HashDefineElectronics/Central-Command/Documentation/Programming Cable Assembly Images/IMG_1886.JPG

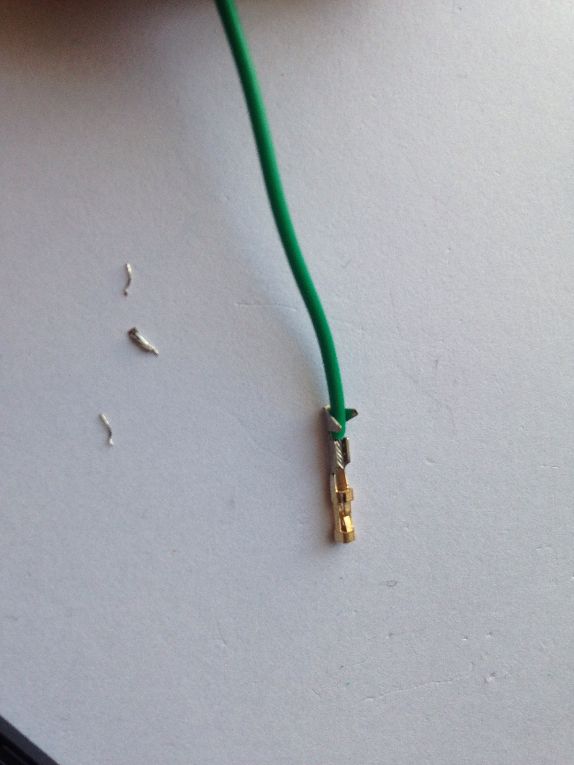
Documentation/Programming Cable Assembly Images/IMG_1886.JPG
