HashDefineElectronics/Central-Command/Documentation/Programming Cable Assembly Images/IMG_1889.JPG

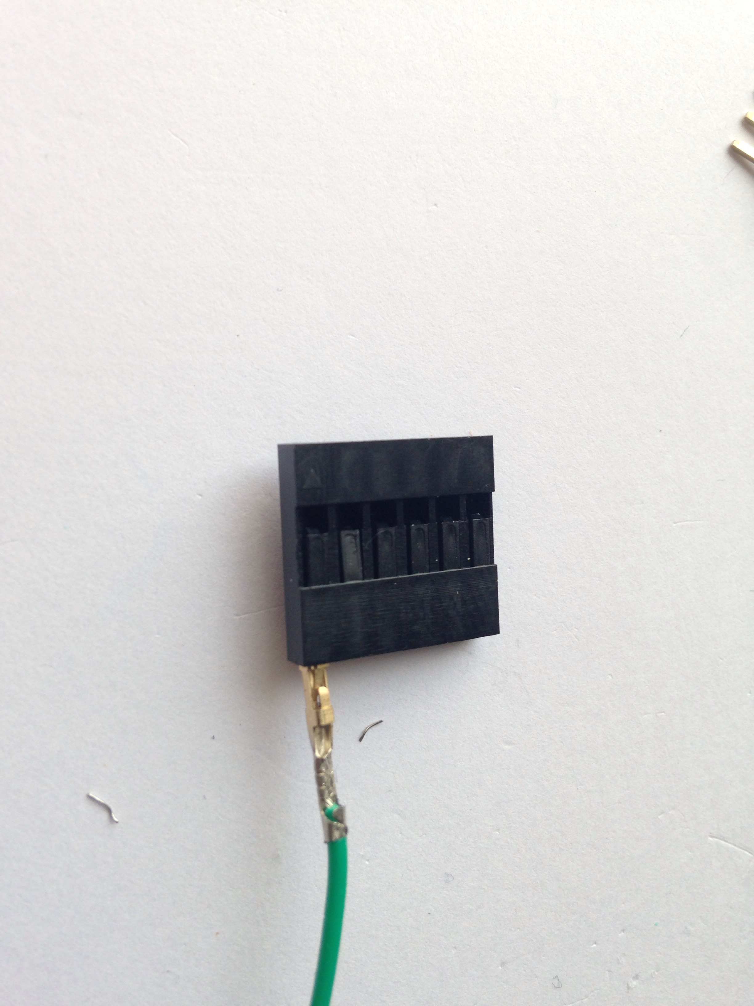
Documentation/Programming Cable Assembly Images/IMG_1889.JPG
