HashDefineElectronics/Central-Command/README.md

# Central-Command
The centralized board that will control the roll with it project
