HashDefineElectronics/Central-Command/Documentation/Specifications.md

# Specifications

## Hardware

*  Hardware review
*  Compiled parts BOM

## Firmware

*  Create CC firmware as makefile
*  Setup unity
*  Create Eclipse CC project

## Repository

*  Setup the .gitignore
*  Create project readme.md

## TDD

## Modular Firmware
