HashDefineElectronics/Central-Command/Hardware/Central Command Invert Small.png

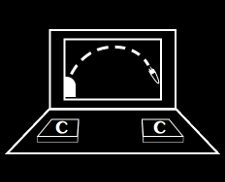
Hardware/Central Command Invert Small.png
