HashDefineElectronics/Central-Command/Documentation/Programming Cable Assembly Images/IMG_1882.JPG

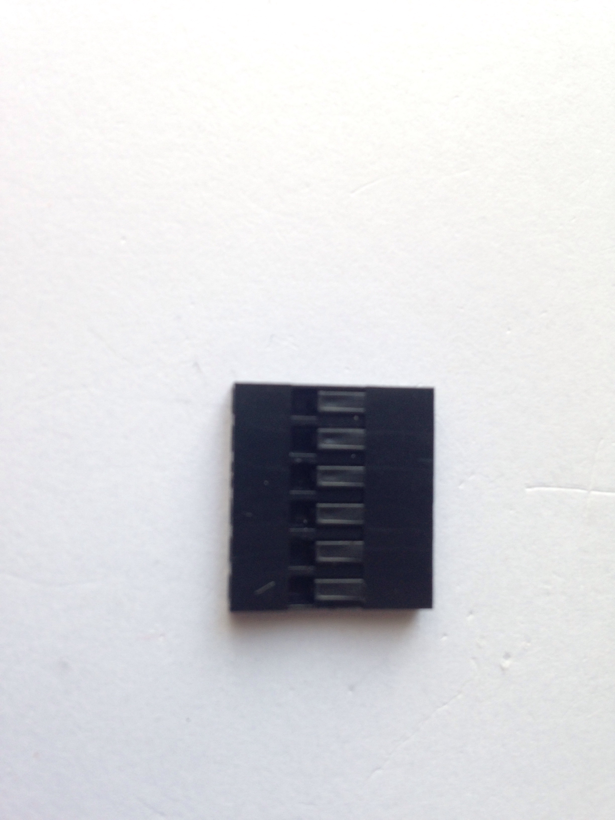
Documentation/Programming Cable Assembly Images/IMG_1882.JPG
