HashDefineElectronics/Central-Command/Documentation/Programming Cable Assembly Images/IMG_1883.JPG

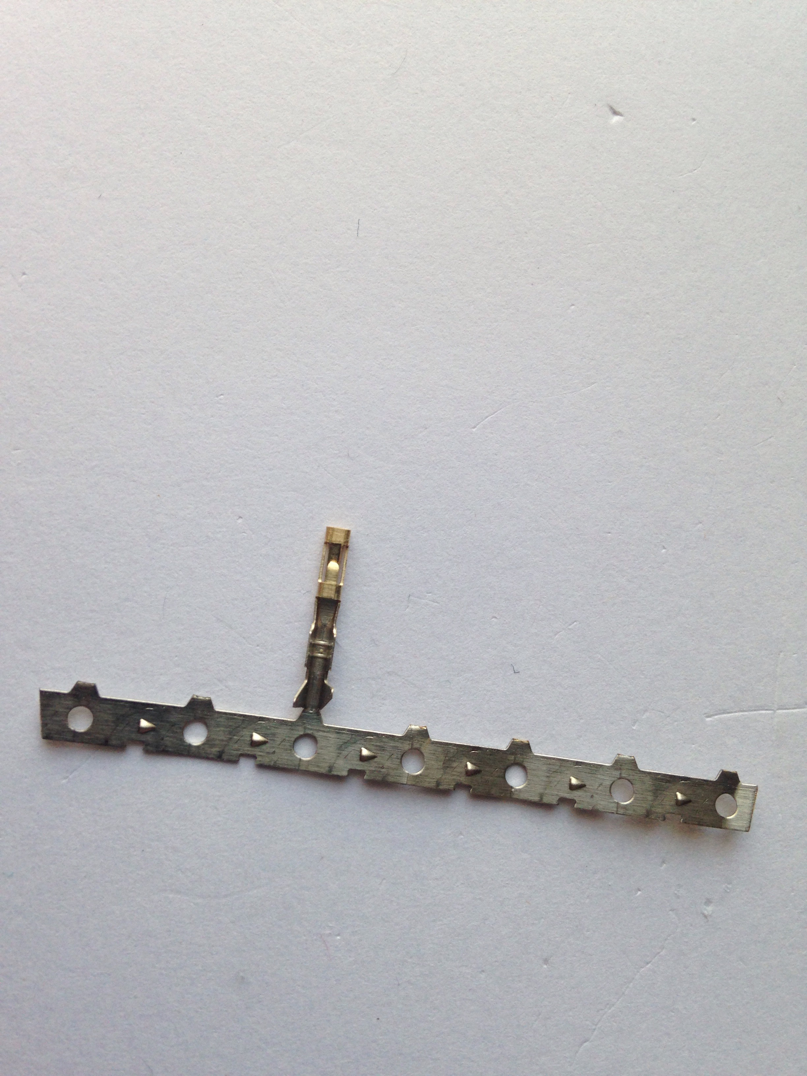
Documentation/Programming Cable Assembly Images/IMG_1883.JPG
