HashDefineElectronics/Central-Command/Documentation/Programming Cable Assembly Images/IMG_1884.JPG

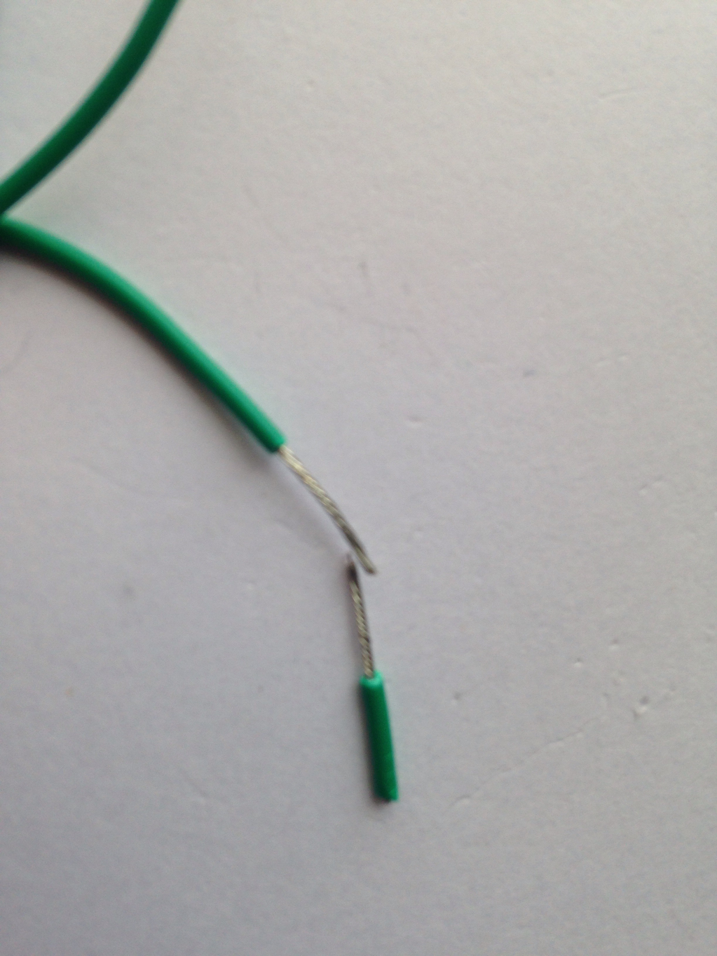
Documentation/Programming Cable Assembly Images/IMG_1884.JPG
