HashDefineElectronics/Central-Command/Documentation/Programming Cable Assembly Images/IMG_1885.JPG

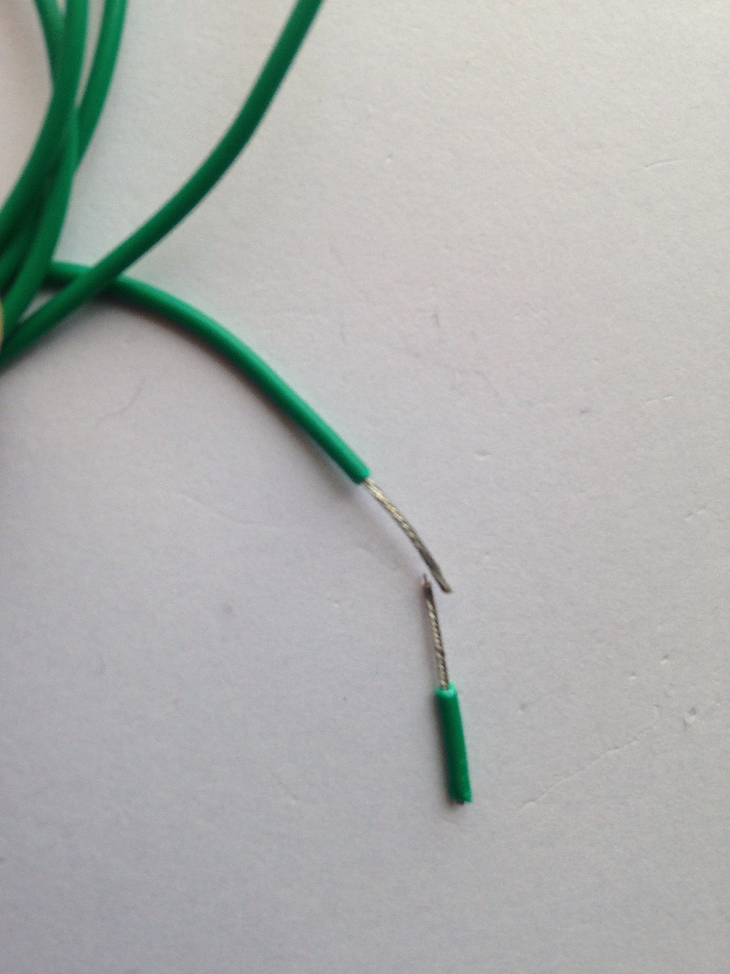
Documentation/Programming Cable Assembly Images/IMG_1885.JPG
