HashDefineElectronics/Central-Command/Documentation/Programming Cable Assembly Images/IMG_1887.JPG

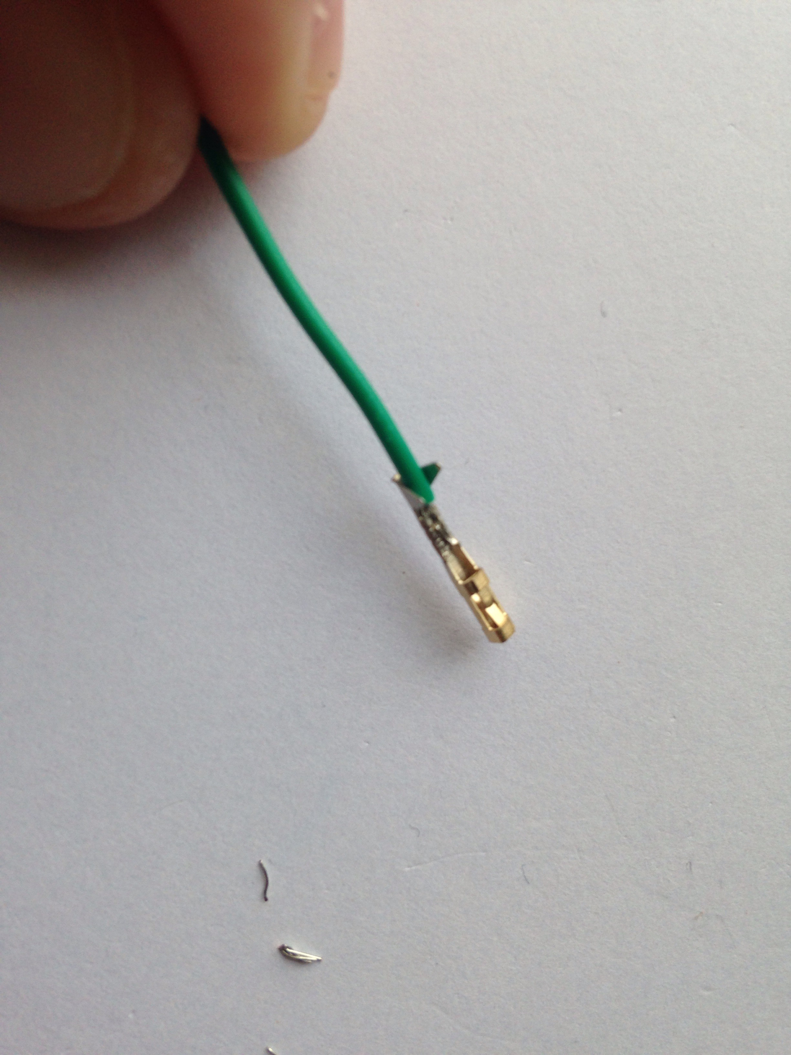
Documentation/Programming Cable Assembly Images/IMG_1887.JPG
