HashDefineElectronics/Central-Command/Documentation/Programming Cable Assembly Images/IMG_1888.JPG

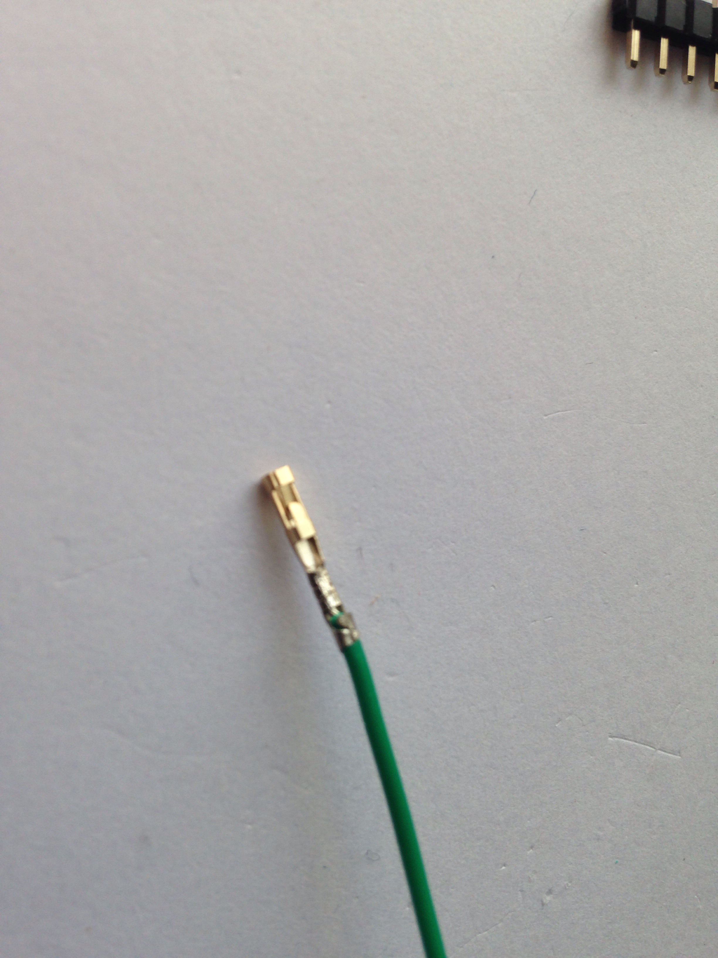
Documentation/Programming Cable Assembly Images/IMG_1888.JPG
