HashDefineElectronics/Central-Command/Documentation/Programming Cable Assembly Images/IMG_1890.JPG

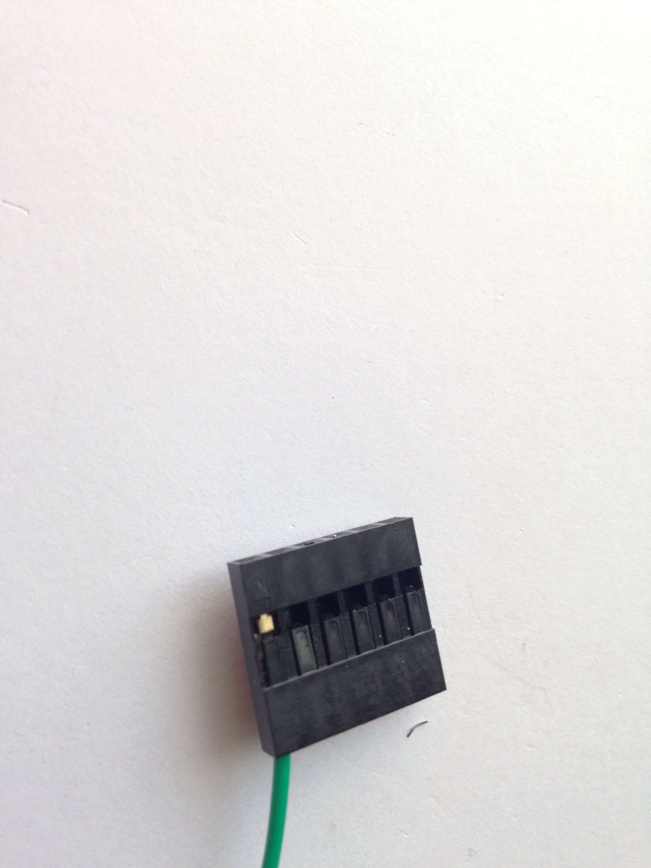
Documentation/Programming Cable Assembly Images/IMG_1890.JPG
