HashDefineElectronics/Central-Command/Hardware/CentralCommand.kicad_pcb

## KiCad design Hardware/CentralCommand.kicad_pcb (2016-02-22)

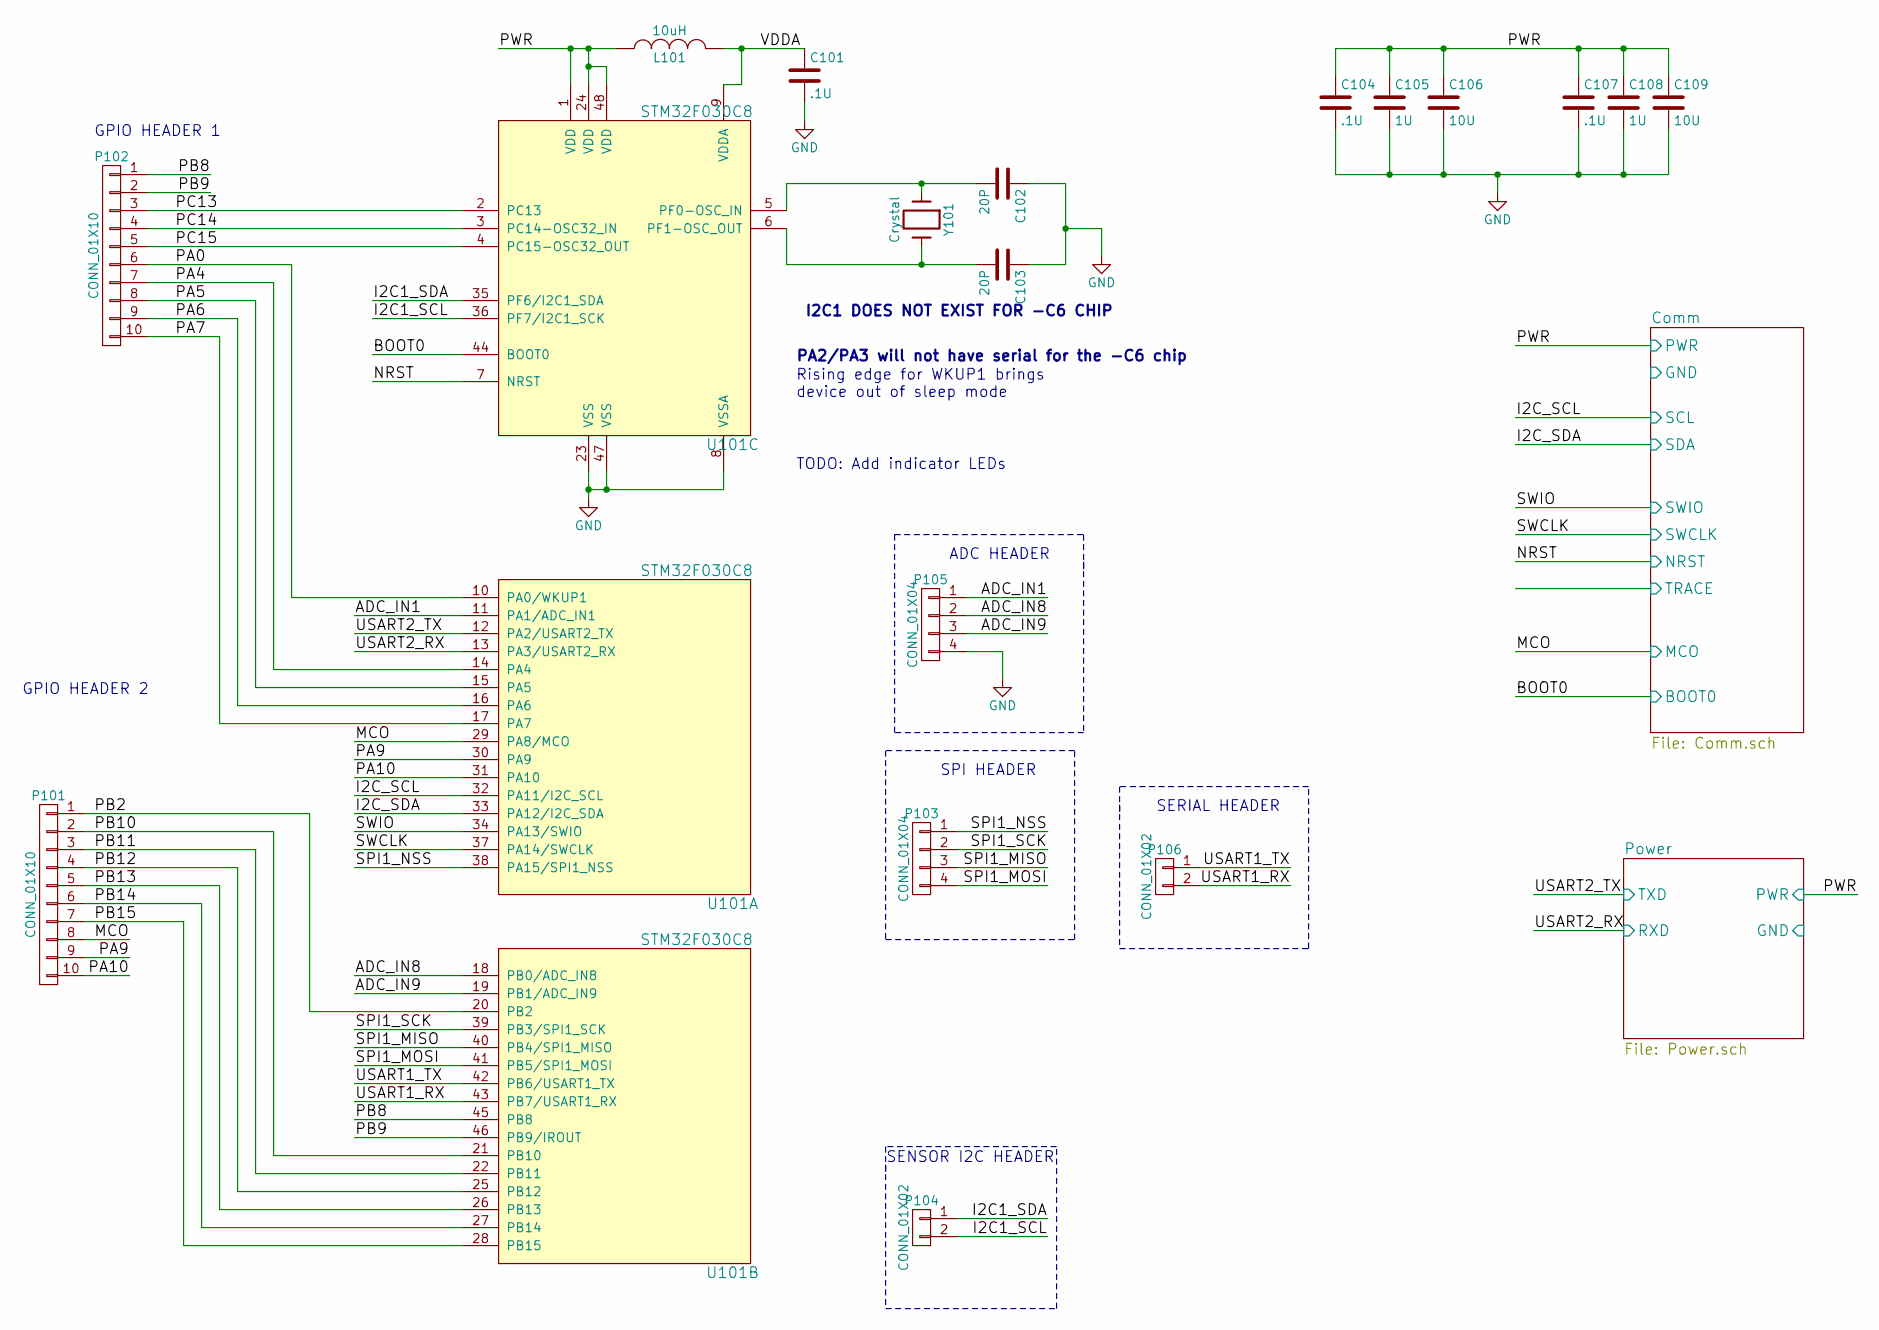
[picture p11: schematic CentralCommand.sch, Central Command]

Parts:
C101, C104, C107: .1U; C_0805; MPN 0805B104K500CT; Farnell 2496944
C102, C103: 20P; C_0805; MPN 08055A200JAT2A; Farnell 2332762
C105, C108: 1U; C_1206; MPN MCSH31B105K100CT; Farnell 1856632
C106, C109: 10U; C_1206; MPN MC1206B106K160CT; Farnell 2320921
L101: 10uH; Neosid_Inductor_SM1206; MPN LQH31CN100K03L; Farnell 1515399
P101, P102: CONN_01X10; Pin_Header_Straight_1x10; MPN M20-9991046; Farnell 1022261
P103, P105: CONN_01X04; Pin_Header_Straight_1x04; MPN M20-9990446; Farnell 1022251
P104, P106: CONN_01X02; Pin_Header_Straight_1x02; MPN M20-9990246; Farnell 1022247
U101: STM32F030C8; LQFP-48_7x7mm_Pitch0.5mm; MPN STM32F030C8; Farnell 2393634
Y101: Crystal; Crystal_HC49-U_Vertical; MPN FOXSLF/080-20; Farnell 2063945

Connections:
/ADC_IN1: P105.1, U101.11 (PA1/ADC_IN1)
/ADC_IN8: P105.2, U101.18 (PB0/ADC_IN8)
/ADC_IN9: P105.3, U101.19 (PB1/ADC_IN9)
/Comm/BOOT0: U101.44 (BOOT0); also elsewhere on the board
/Comm/NRST: U101.7 (NRST); also elsewhere on the board
/Comm/PWR: C104.1, C105.1, C106.1, C107.1, C108.1, C109.1, L101.1, U101.1 (VDD), U101.24 (VDD), U101.48 (VDD); also elsewhere on the board
/Comm/SCL: U101.32 (PA11/I2C_SCL); also elsewhere on the board
/Comm/SDA: U101.33 (PA12/I2C_SDA); also elsewhere on the board
/Comm/SWCLK: U101.37 (PA14/SWCLK); also elsewhere on the board
/Comm/SWIO: U101.34 (PA13/SWIO); also elsewhere on the board
/I2C1_SCL: P104.2, U101.36 (PF7/I2C1_SCK)
/I2C1_SDA: P104.1, U101.35 (PF6/I2C1_SDA)
/MCO: P101.8, U101.29 (PA8/MCO)
/PA0: P102.6, U101.10 (PA0/WKUP1)
/PA4: P102.7, U101.14 (PA4)
/PA5: P102.8, U101.15 (PA5)
/PA6: P102.9, U101.16 (PA6)
/PA7: P102.10, U101.17 (PA7)
/PA9: P101.9, U101.30 (PA9)
/PA10: P101.10, U101.31 (PA10)
/PB2: P101.1, U101.20 (PB2)
/PB8: P102.1, U101.45 (PB8)
/PB9: P102.2, U101.46 (PB9/IROUT)
/PB10: P101.2, U101.21 (PB10)
/PB11: P101.3, U101.22 (PB11)
/PB12: P101.4, U101.25 (PB12)
/PB13: P101.5, U101.26 (PB13)
/PB14: P101.6, U101.27 (PB14)
/PB15: P101.7, U101.28 (PB15)
/PC13: P102.3, U101.2 (PC13)
/PC14: P102.4, U101.3 (PC14-OSC32_IN)
/PC15: P102.5, U101.4 (PC15-OSC32_OUT)
/Power/RXD: U101.13 (PA3/USART2_RX); also elsewhere on the board
/Power/TXD: U101.12 (PA2/USART2_TX); also elsewhere on the board
/SPI1_MISO: P103.3, U101.40 (PB4/SPI1_MISO)
/SPI1_MOSI: P103.4, U101.41 (PB5/SPI1_MOSI)
/SPI1_NSS: P103.1, U101.38 (PA15/SPI1_NSS)
/SPI1_SCK: P103.2, U101.39 (PB3/SPI1_SCK)
/USART1_RX: P106.2, U101.43 (PB7/USART1_RX)
/USART1_TX: P106.1, U101.42 (PB6/USART1_TX)
/VDDA: C101.1, L101.2, U101.9 (VDDA)
GND: C101.2, C102.1, C103.1, C104.2, C105.2, C106.2, C107.2, C108.2, C109.2, P105.4, U101.8 (VSSA), U101.23 (VSS), U101.47 (VSS); also elsewhere on the board
unnamed: C102.2, U101.5 (PF0-OSC_IN), Y101.1
unnamed: C103.2, U101.6 (PF1-OSC_OUT), Y101.2

Notes on the sheet:
I2C1 DOES NOT EXIST FOR -C6 CHIP
PA2/PA3 will not have serial for the -C6 chip
Rising edge for WKUP1 brings device out of sleep mode
GPIO HEADER 1
ADC HEADER
SPI HEADER
SERIAL HEADER
SENSOR I2C HEADER
GPIO HEADER 2
TODO: Add indicator LEDs

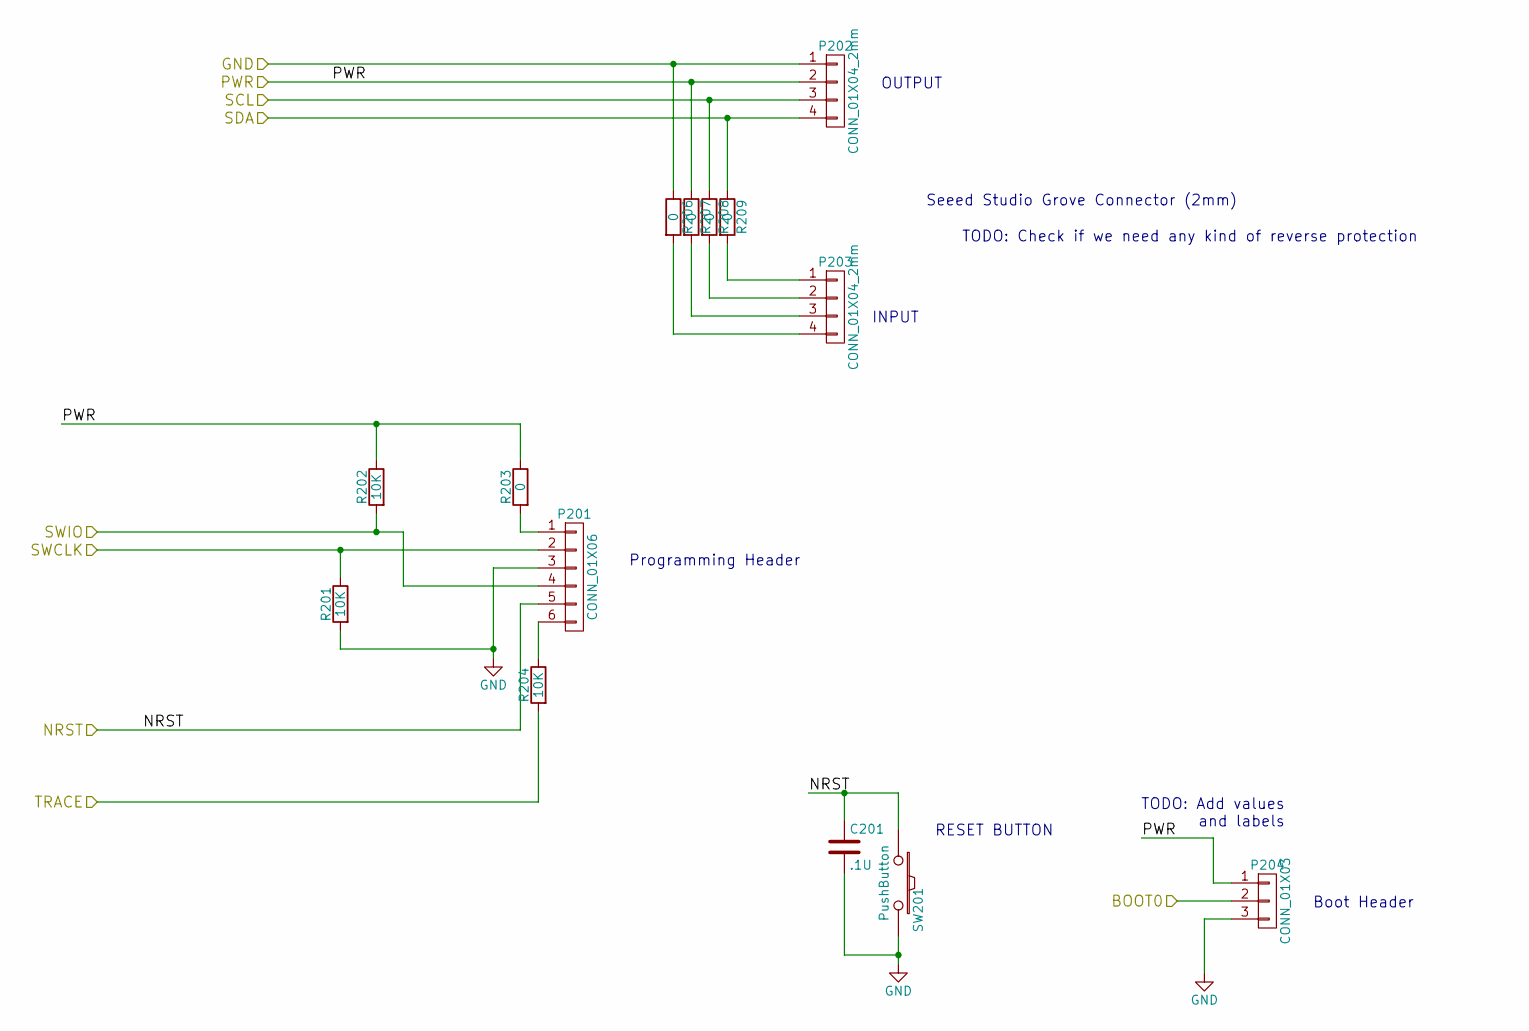
[picture p12: schematic Comm.sch]

Parts:
C201: .1U; C_0805; MPN 0805B104K500CT; Farnell 2496944
P201: CONN_01X06; Pin_Header_Straight_1x06; MPN M20-9990646; Farnell 1022255
P202, P203: CONN_01X04_2mm; Grove-2mm; MPN M22-2510405; Farnell 2289778
P204: CONN_01X03; Pin_Header_Straight_1x03; MPN M20-9990346; Farnell 1022249
R201, R202, R204: 10K; R_0805; MPN MCWR08X1002FTL; Farnell 2447553
R203, R206, R207, R208, R209: 0; R_0805; MPN MC01W08050R; Farnell 9333681
SW201: PushButton; FSM2JSMAA-ND; MPN FSM2JSMAA; Farnell 2468760

Connections:
/Comm/BOOT0: P204.2; also elsewhere on the board
/Comm/NRST: C201.1, P201.5, SW201.1; also elsewhere on the board
/Comm/PWR: P202.2, P204.1, R202.1, R203.1, R207.1; also elsewhere on the board
/Comm/SCL: P202.3, R208.1; also elsewhere on the board
/Comm/SDA: P202.4, R209.1; also elsewhere on the board
/Comm/SWCLK: P201.2, R201.1; also elsewhere on the board
/Comm/SWIO: P201.4, R202.2; also elsewhere on the board
/Comm/TRACE: R204.2
GND: C201.2, P201.3, P202.1, P204.3, R201.2, R206.1, SW201.2; also elsewhere on the board
unnamed: P201.1, R203.2
unnamed: P201.6, R204.1
unnamed: P203.1, R209.2
unnamed: P203.2, R208.2
unnamed: P203.3, R207.2
unnamed: P203.4, R206.2

Notes on the sheet:
Seeed Studio Grove Connector (2mm)
TODO: Check if we need any kind of reverse protection
Programming Header
RESET BUTTON
TODO: Add values and labels
Boot Header
OUTPUT
INPUT

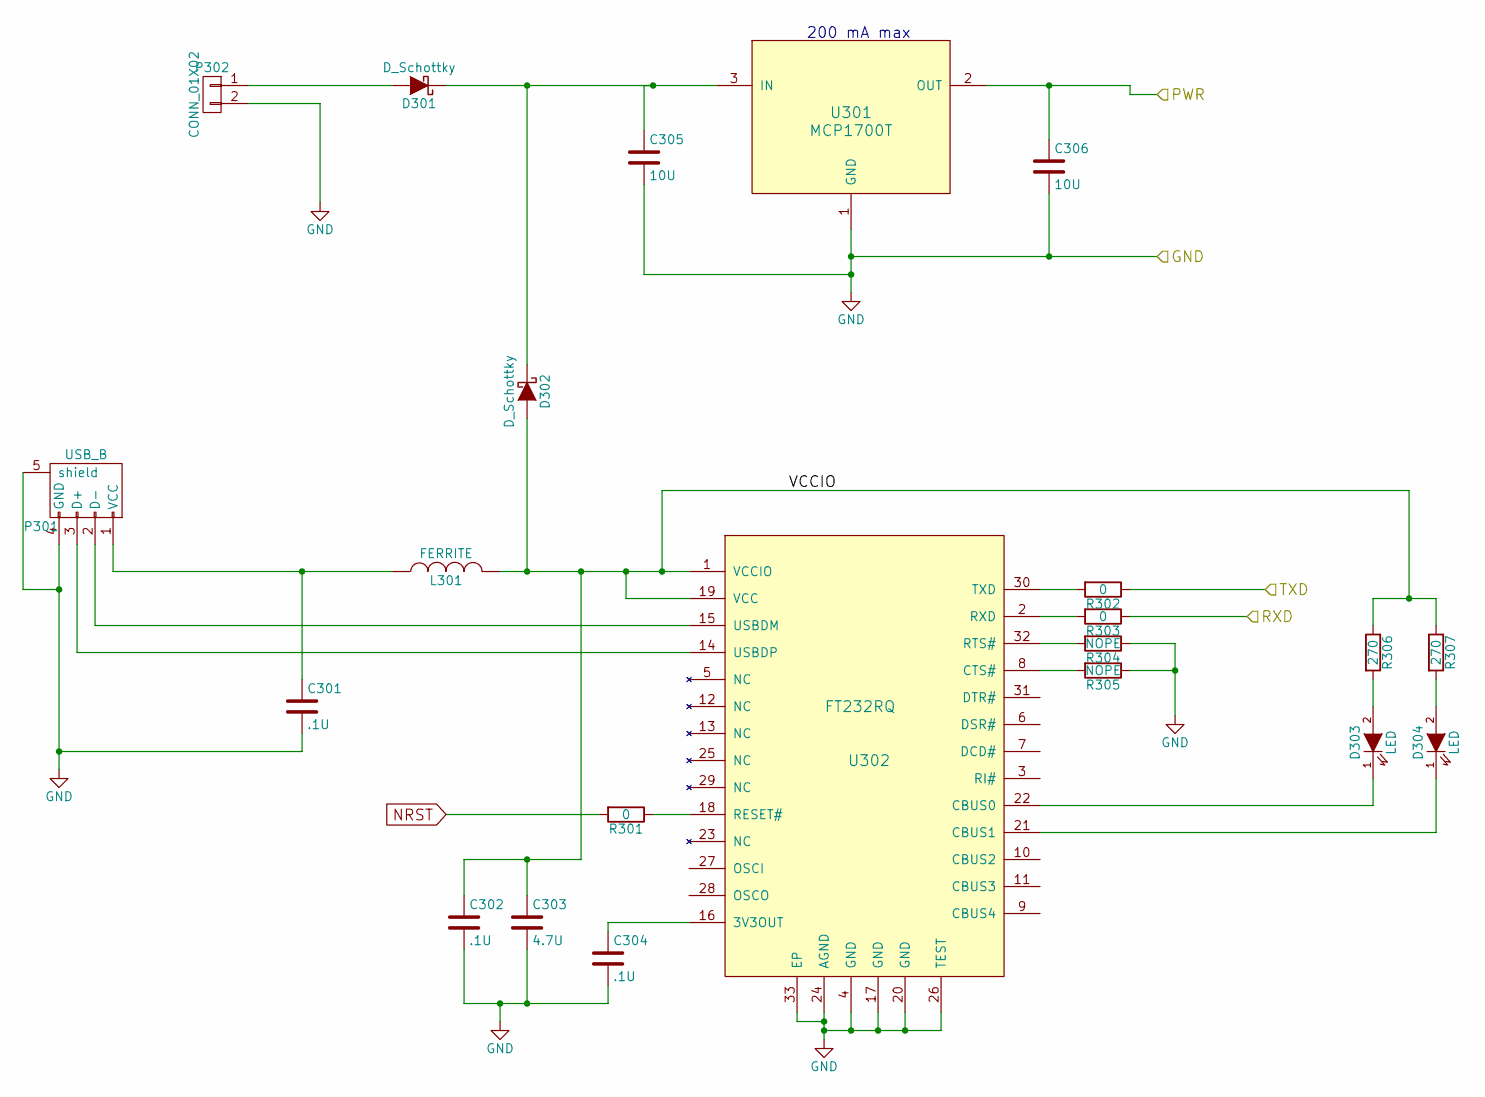
[picture p13: schematic Power.sch]

Parts:
C301, C302, C304: .1U; C_0805; MPN 0805B104K500CT; Farnell 2496944
C303: 4.7U; C_1210; MPN GRM32RR71C475KA01L; Farnell 1845775
C305, C306: 10U; C_1210; MPN C1210C106Z4VACTU; Farnell 9227989
D301, D302: D_Schottky; Diode-SMA_Standard; MPN B130-13-F; Farnell 1843713
D303, D304: LED; LED-0805; MPN SML-LXT0805GW-TR; Farnell 2062259
L301: FERRITE; Neosid_Inductor_SM1206; MPN 742792605; Farnell 1800342
P301: USB_B; 10118193; MPN 10118193 or USB3075-30-A; Digi-Key 609-4616-1-ND
P302: CONN_01X02; Pin_Header_Straight_1x02; MPN M20-9990246; Farnell 1022247
R301, R302, R303: 0; R_0805; MPN MC01W08050R; Farnell 9333681
R304, R305: NOPE; R_0805
R306, R307: 270; R_0805; MPN MCWR08X2700FTL; Farnell 2447618
U301: MCP1700T; SOT-23; MPN MCP1700T-3302E/TT_; Farnell 1296592
U302: FT232RQ; QFN-32-1EP_5x5mm_Pitch0.5mm; MPN FT232RQ-REEL; Farnell 1146033

Connections:
/Comm/PWR: C306.1, U301.2 (OUT); also elsewhere on the board
/Power/RXD: R303.1; also elsewhere on the board
/Power/TXD: R302.1; also elsewhere on the board
/Power/VCCIO: C302.1, C303.1, D302.2 (A), L301.2, R306.1, R307.1, U302.1 (VCCIO), U302.19 (VCC)
GND: C301.2, C302.2, C303.2, C304.2, C305.2, C306.2, P301.4 (GND), P301.5 (shield), P301.6, P301.7, P301.8, P301.9, P302.2, R304.1, R305.1, U301.1 (GND), U302.4 (GND), U302.17 (GND), U302.20 (GND), U302.24 (AGND), U302.26 (TEST), U302.33 (EP); also elsewhere on the board
NRST: R301.2
unnamed: C301.1, L301.1, P301.1 (VCC)
unnamed: C304.1, U302.16 (3V3OUT)
unnamed: C305.1, D301.1 (K), D302.1 (K), U301.3 (IN)
unnamed: D301.2 (A), P302.1
unnamed: D303.1 (K), U302.22 (CBUS0)
unnamed: D303.2 (A), R306.2
unnamed: D304.1 (K), U302.21 (CBUS1)
unnamed: D304.2 (A), R307.2
unnamed: P301.2 (D-), U302.15 (USBDM)
unnamed: P301.3 (D+), U302.14 (USBDP)
unnamed: R301.1, U302.18 (RESET#)
unnamed: R302.2, U302.30 (TXD)
unnamed: R303.2, U302.2 (RXD)
unnamed: R304.2, U302.32 (RTS#)
unnamed: R305.2, U302.8 (CTS#)

Notes on the sheet:
200 mA max

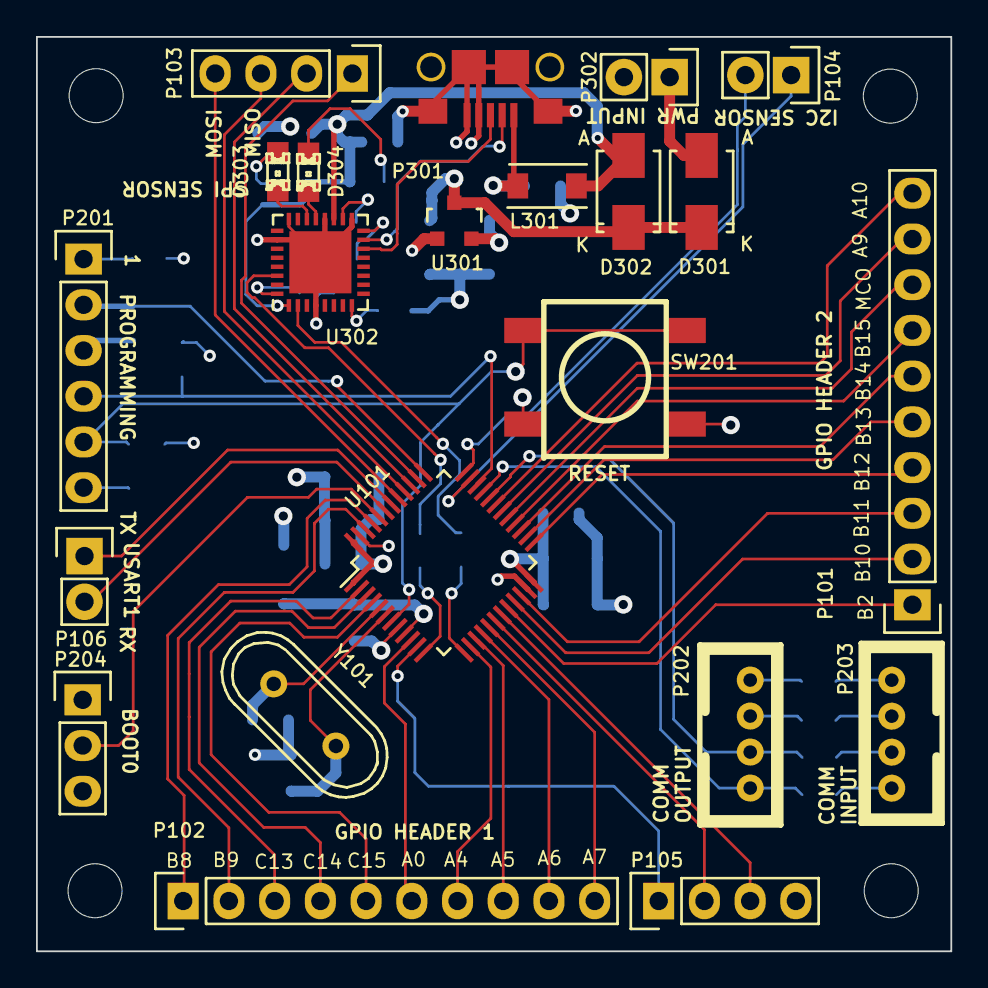
[picture p14: board CentralCommand.kicad_pcb from above]

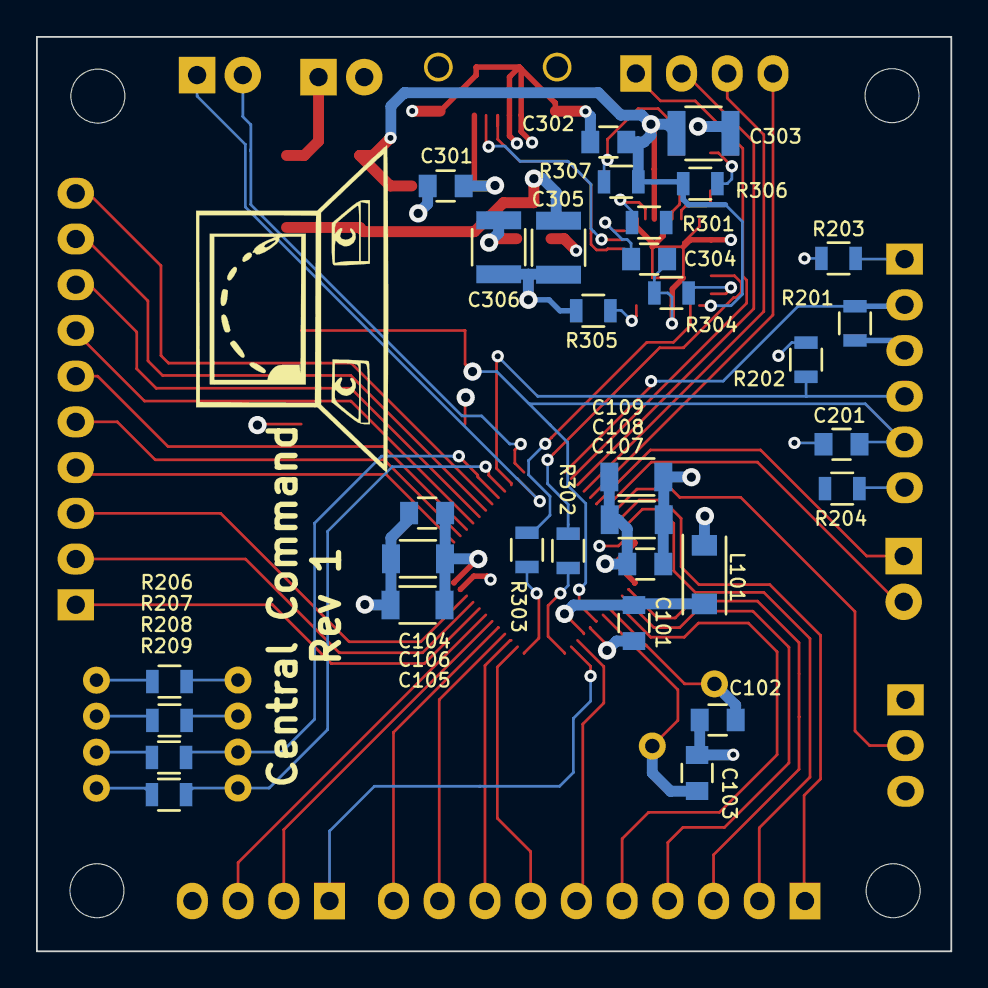
[picture p15: board CentralCommand.kicad_pcb from below]

Board: 4 copper layers, 50.8 x 50.8 mm, 54 parts (32 on the bottom side), 66 nets.
