HashDefineElectronics/Central-Command/(commit log)

2015-10-11 New schematic
    [Central Command.sch]
2015-10-11 Added initial STM32 footprint
2015-10-13 Finished assigning pins to the 3 banks of the symbol
    [Central Command.sch]
2015-10-21 Added footprint for 3.3V fixed linear regulator and associated circuitry
    [Central Command.sch]
2015-10-25 Updated pinout names and added programming headers
    [Central Command.sch]
2015-10-27 Added ADC pins to STM32 symbol
2015-11-20 Changed out schematic symbol to match schematic in CC11 video. Should have been saved last time.
    [Central Command.sch]
2015-11-20 Created layout, imported main 48 pin QFP
    [Central Command.kicad_pcb, Central Command.sch]
2015-11-23 Added Crystal to the schematic and layout
    [Central Command.kicad_pcb, Central Command.sch]
2015-11-23 Changed BOOT0 pin hookup, added reset button
    [Central Command.sch]
2015-11-25 Added a USB to serial section
    [Central Command.kicad_pcb, Central Command.sch, Power.sch]
2015-11-25 Added more decoupling caps, indicator LEDs and hooked reset into the FTDI chip
    [Power.sch]
2015-12-02 Added headers and created a new sheet for communication headers
    [Central Command.sch, Comm.sch, Power.sch]
2015-12-08 Associated footprints, created footprints for 2mm connector and did prelim placement
    [Central Command.kicad_pcb, Central Command.sch, Comm.sch, Power.sch]
2015-12-09 Small changes after last large save
    [Central Command.sch]
2015-12-09 Changed board outline (now 2x2) and placed headers around the outside based on pin connections.
    [Central Command.kicad_pcb, Central Command.sch]
2015-12-10 Swapped connections on the Grove connector
    [Comm.sch]
2015-12-22 Added ground and power layers.
    [Central Command.kicad_pcb, Central Command.sch, Comm.sch, _saved_Comm.sch, _saved_Power.sch]
2015-12-22 Added mounting holes (again?)
    [Central Command.kicad_pcb]
2015-12-22 Finished laying out power section
    [Central Command.kicad_pcb, Central Command.sch, Comm.sch, Power.sch, _saved_Comm.sch, _saved_Power.sch]
2015-12-23 Ripped up previous power layout and placed all FTDI components (finished page 3 of schematic)
    [Central Command.kicad_pcb, Power.sch]
2015-12-26 Swapped two connectors and routed the bottom connector
    [Central Command.kicad_pcb, Central Command.sch, Comm.sch, Power.sch]
2015-12-26 Removed one header and finished connecting all parts
    [Central Command.kicad_pcb, Comm.sch]
2015-12-26 Finished layout including labels and DRC
    [Central Command-B_Cu.gbr, Central Command-B_Mask.gbr, Central Command-B_Paste.gbr, Central Command-B_SilkS.gbr, Central Command-Edge_Cuts.gbr, Central Command-F_Cu.gbr, Central Command-F_Mask.gbr, Central Command-F_Paste.gbr]
2016-01-05 Finished board and generated gerbers
    [Central Command-B.Cu.gbr, Central Command-B.Mask.gbr, Central Command-B.Paste.gbr, Central Command-B.SilkS.gbr, Central Command-Edge.Cuts.gbr, Central Command-F.Cu.gbr, Central Command-F.Mask.gbr, Central Command-F.Paste.gbr]
2016-01-14 - Added Documentation folder - Move cad files to the hardware folder - generated the html BOM
    [Central Command-B.Cu.gbr, Central Command-B.Mask.gbr, Central Command-B.Paste.gbr, Central Command-B.SilkS.gbr, Central Command-Edge.Cuts.gbr, Central Command-F.Cu.gbr, Central Command-F.Mask.gbr, Central Command-F.Paste.gbr]
2016-01-19 Rename project files to remove the space between 'Central' & 'Command' for the XSL processing of the BOM
    [Central Command.csv, CentralCommand.csv, CentralCommand.kicad_pcb, CentralCommand.sch, Comm.sch, Power.sch]
2016-01-27 - Added Farnell and digi-key supplier numbers to most past. Still need todo crystal, switch and micro inductor. - updated the HTML BOM and CSV
    [CentralCommand.csv, CentralCommand.sch, Comm.sch, Power.sch]
2016-01-27 Added the farnell code for the last few parts
    [CentralCommand.csv, CentralCommand.sch, Comm.sch]
2016-01-27 minor farnell number correction
    [CentralCommand.csv, Power.sch]
2016-01-28 Fixed the seed studion connect farnell code. It now points to the 2mm version
    [CentralCommand.csv, Comm.sch, Power.sch]
2016-02-01 Added the programming cable documentation and images
2016-02-03 XML file from creating BOM
2016-02-10 - added eclipse test project - added stm32 datasheet
2016-02-11 The boardtest project will now enable the MCO so that we can meassure the system internal clock.
2016-02-22 Ported the serial iterface code from the embedded
    [CentralCommand.kicad_pcb]
2016-07-29 - Added the CE official KiCad Libary as a submodule. - also adde the gitignore to the main kicad project file.
2016-09-28 Added the changes made to the KiCad libs
2016-09-28 updated the CE_KiCadLib libary and update the Project library ref
    [CentralCommand.sch, Comm.sch, Power.sch]
